David-Vazquez47/Banda-Transportadora/HMI ADAPTER/Marco del HMI.SLDPRT

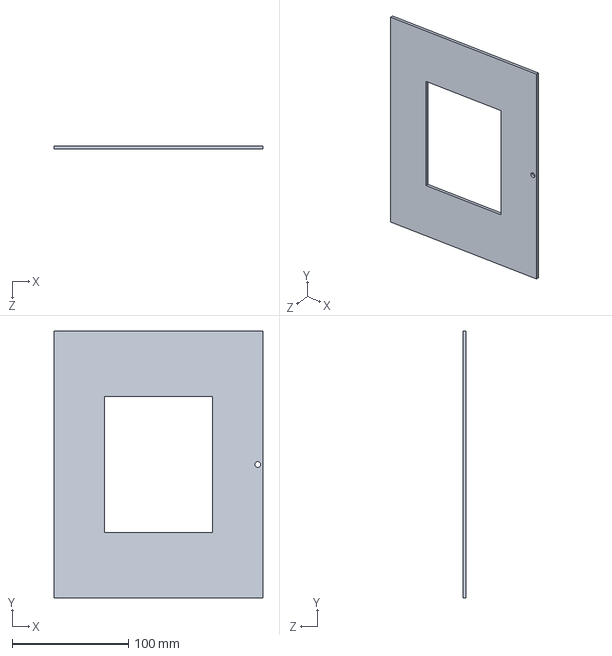
[picture p1: CAD file, 2026-10-13]
HMI ADAPTER/Marco del HMI.SLDPRT
180.0 x 230.0 x 3.00 mm
