David-Vazquez47/Banda-Transportadora/(list of files, cad)

Other CAD files:
HMI ADAPTER/Marco del HMI.DXF
