David-Vazquez47/Banda-Transportadora/HMI ADAPTER/Diseño del Marco.pdf

E E

F F

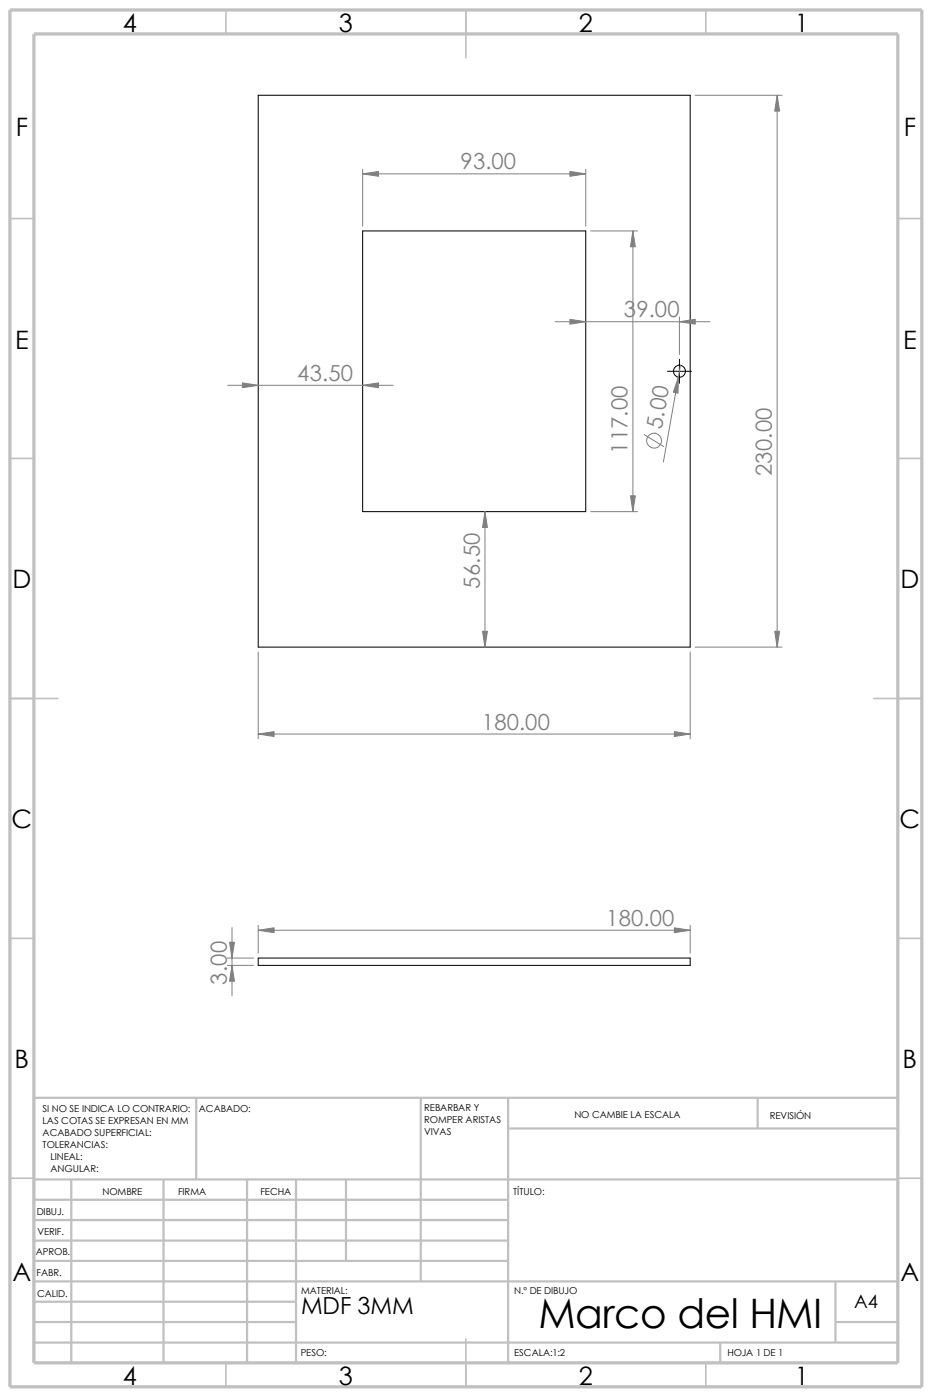
[picture p2: page 1]
REVISIÓN; N.º DE DIBUJO; ESCALA:1:2; HOJA 1 DE 1; PESO:; MDF 3MM; ROMPER ARISTAS; ACABADO:; FABR.; CALID.; VIVAS; REBARBAR Y; MATERIAL:; Marco del HMI ³.00

SI NO SE INDICA LO CONTRARIO:
LAS COTAS SE EXPRESAN EN MM
ACABADO SUPERFICIAL:
TOLERANCIAS:
LINEAL:
ANGULAR:

NO CAMBIE LA ESCALA

NOMBRE | FIRMA | FECHA | TÍTULO:

DIBUJ.
VERIF.
APROB.
