David-Vazquez47/Banda-Transportadora/Planos_Electroneumaticos_Banda_v1.0_20Oct26.pdf

+52 (999) 930 1900

97305

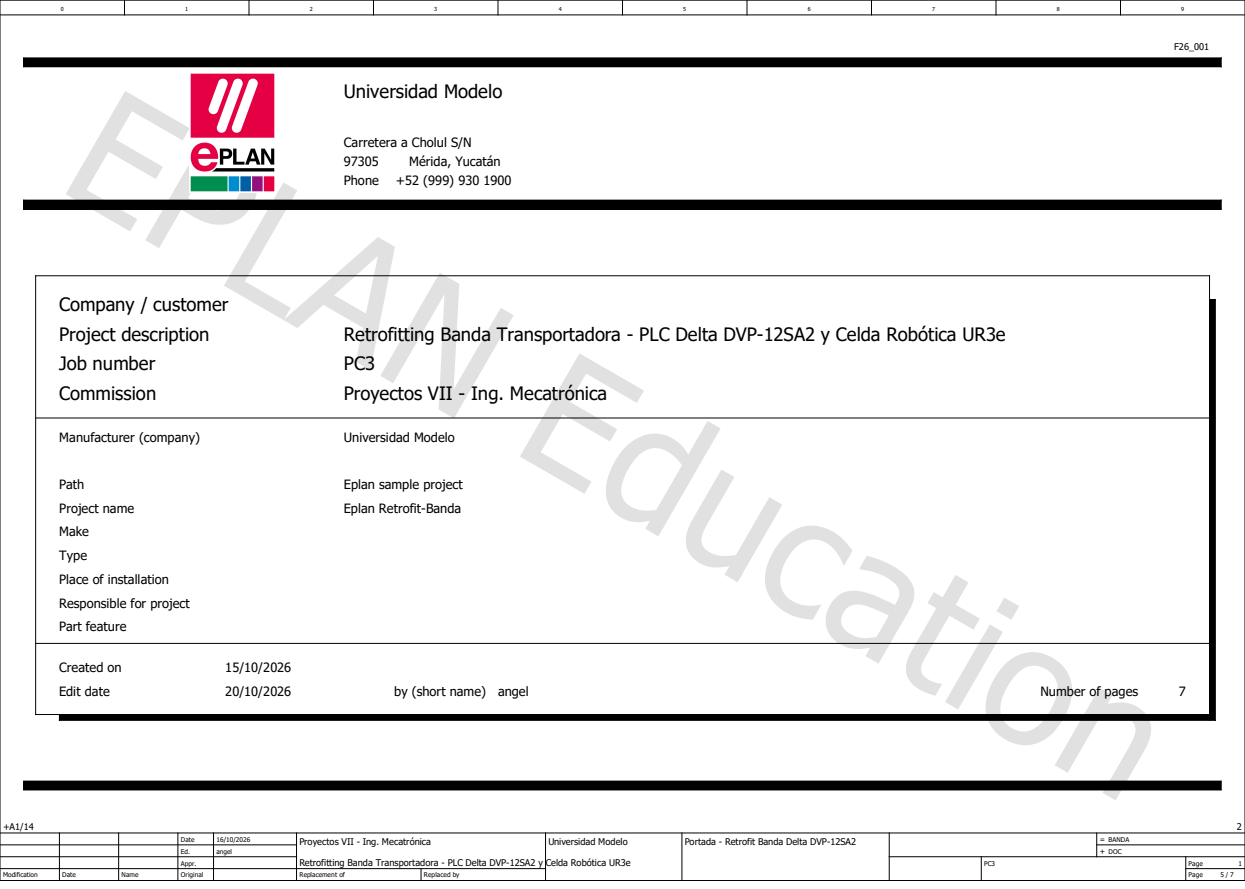
[picture p3: page 1]
Page Page Retrofitting Banda Transportadora - PLC Delta DVP-12SA2 y Celda Robótica UR3e Ed. +A1/14; Original; PC3 Proyectos VII - Ing. Mecatrónica; Date; Replaced by; BANDA DOC; Modification; Appr.; Replacement of; Name; Universidad Modelo; Project description; Retrofitting Banda Transportadora - PLC Delta DVP-12SA2 y Celda Robótica UR3e; Commission; Edit date; Created on; Job number; angel; Carretera a Cholul S/N; Manufacturer (company); Project name; Eplan Retrofit-Banda; Phone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

Proyectos VII - Ing. Mecatrónica

Path
Make
Type
Place of installation
Responsible for project
Part feature

Eplan sample project

by (short name)

Number of pages

Universidad Modelo | Portada - Retrofit Banda Delta DVP-12SA2 | =
16/10/2026 angel | | | 1 +

Page | Page type | Page description | Date | Edited by
=BANDA+A1/10 | Schematic multi-line | Distribución 220VAC / 24VDC y Potencia Motor JSCC | 19/10/2026 | David Vazquez

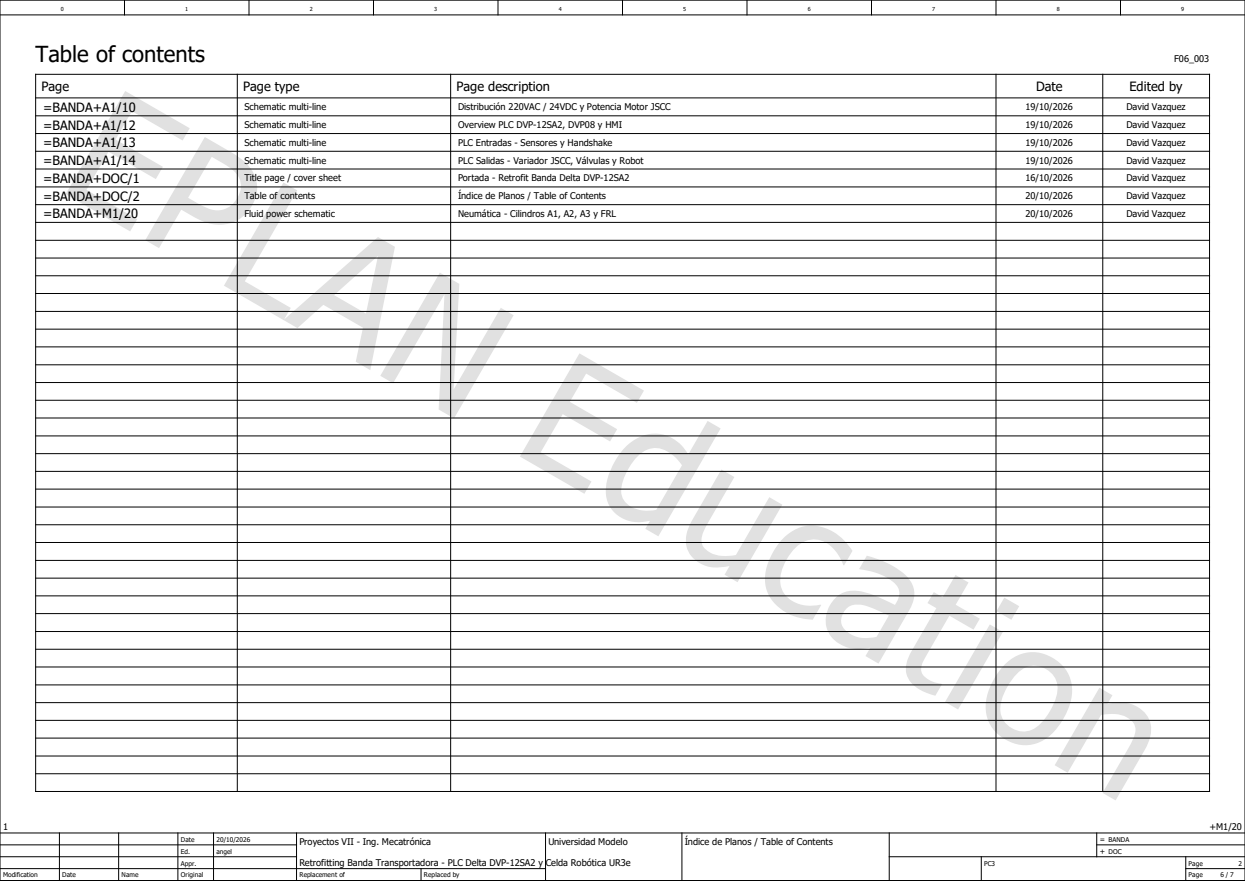
[picture p4: page 2]
Page Page Retrofitting Banda Transportadora - PLC Delta DVP-12SA2 y Celda Robótica UR3e Ed. 1; Original; PC3 Proyectos VII - Ing. Mecatrónica; Date; Replaced by; BANDA DOC; Modification; Appr.; Replacement of; Name

Table of contents

=BANDA+A1/12 | Schematic multi-line | Overview PLC DVP-12SA2, DVP08 y HMI | 19/10/2026 | David Vazquez
=BANDA+A1/13 | Schematic multi-line | PLC Entradas - Sensores y Handshake | 19/10/2026 | David Vazquez
=BANDA+A1/14 | Schematic multi-line | PLC Salidas - Variador JSCC, Válvulas y Robot | 19/10/2026 | David Vazquez
=BANDA+DOC/1 | Title page / cover sheet | | 16/10/2026 Portada - Retrofit Banda Delta DVP-12SA2 | David Vazquez
=BANDA+DOC/2 | Table of contents | | 20/10/2026 Índice de Planos / Table of Contents | David Vazquez
=BANDA+M1/20 | Fluid power schematic | | 20/10/2026 Neumática - Cilindros A1, A2, A3 y FRL | David Vazquez

Universidad Modelo | Índice de Planos / Table of Contents | =
20/10/2026 angel | | | 2 +

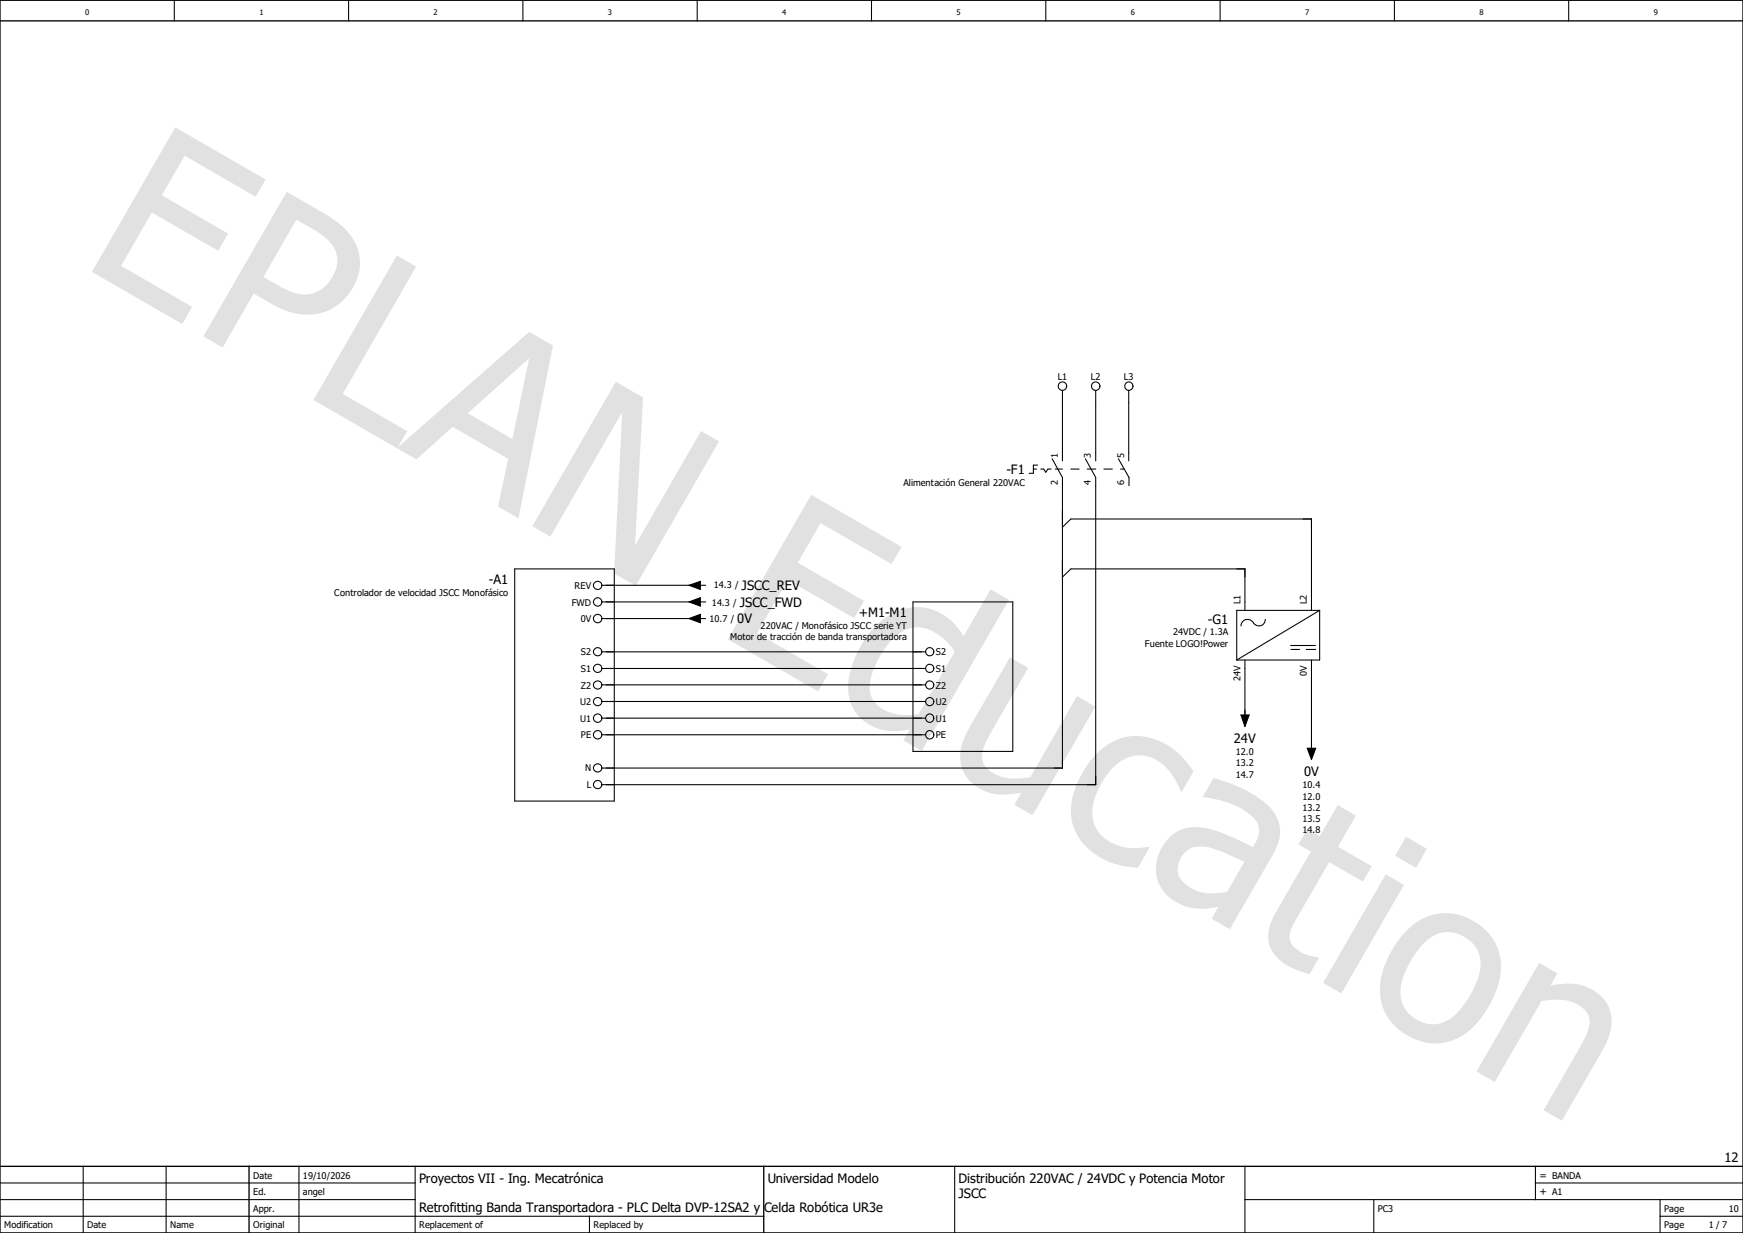
[picture p5: page 3]
Page Page Retrofitting Banda Transportadora - PLC Delta DVP-12SA2 y Celda Robótica UR3e Ed. Original; PC3 Proyectos VII - Ing. Mecatrónica; Date; Replaced by; BANDA; Modification; Appr.; Replacement of; Name; -F1 Alimentación General 220VAC; -A1 Controlador de velocidad JSCC Monofásico; REV; FWD 0V; S2S1Z2U2U1PEN; -G1 24VDC / 1.3A; 220VAC / Monofásico JSCC serie YT Motor de tracción de banda transportadora; 14.3 / JSCC_REV 14.3 / JSCC_FWD

Fuente LOGO!Power +M1-M1

Universidad Modelo | = A1 Distribución 220VAC / 24VDC y Potencia Motor JSCC
19/10/2026 angel | | 10 +

## -PLC1

## -PLC2

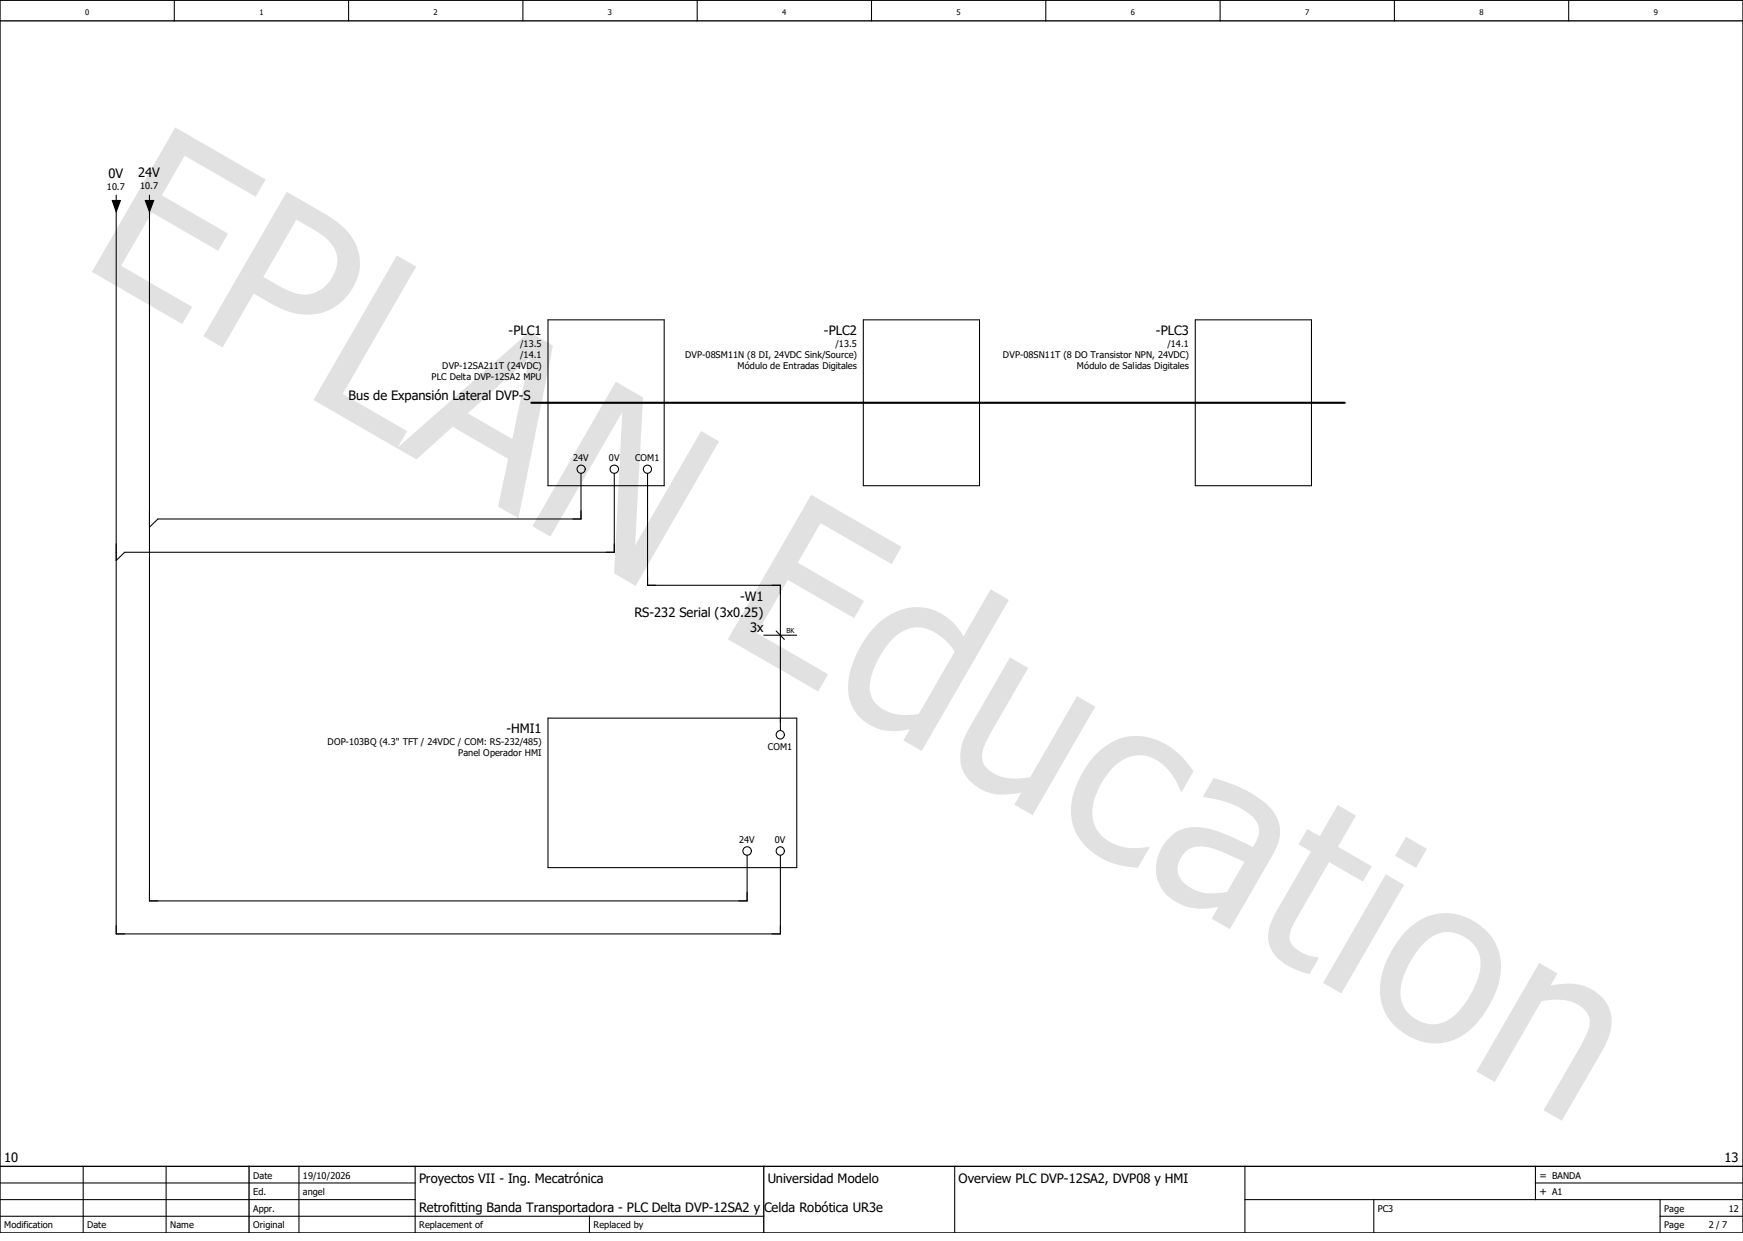
[picture p6: page 4]
Page Page Retrofitting Banda Transportadora - PLC Delta DVP-12SA2 y Celda Robótica UR3e Ed. 10; Original; PC3 Proyectos VII - Ing. Mecatrónica; Date; Replaced by; BANDA; Modification; Appr.; Replacement of; Name; -PLC3; -HMI1 DOP-103BQ (4.3" TFT / 24VDC / COM: RS-232/485) Panel Operador HMI; COM1; 3x RS-232 Serial (3x0.25)

/13.5 DVP-08SM11N (8 DI, 24VDC Sink/Source) Módulo de Entradas Digitales

/14.1 DVP-08SN11T (8 DO Transistor NPN, 24VDC) Módulo de Salidas Digitales

/14.1 DVP-12SA211T (24VDC) PLC Delta DVP-12SA2 MPU

Bus de Expansión Lateral DVP-S

Universidad Modelo | = A1 Overview PLC DVP-12SA2, DVP08 y HMI
19/10/2026 angel | | 12 +

## -PLC1

0V

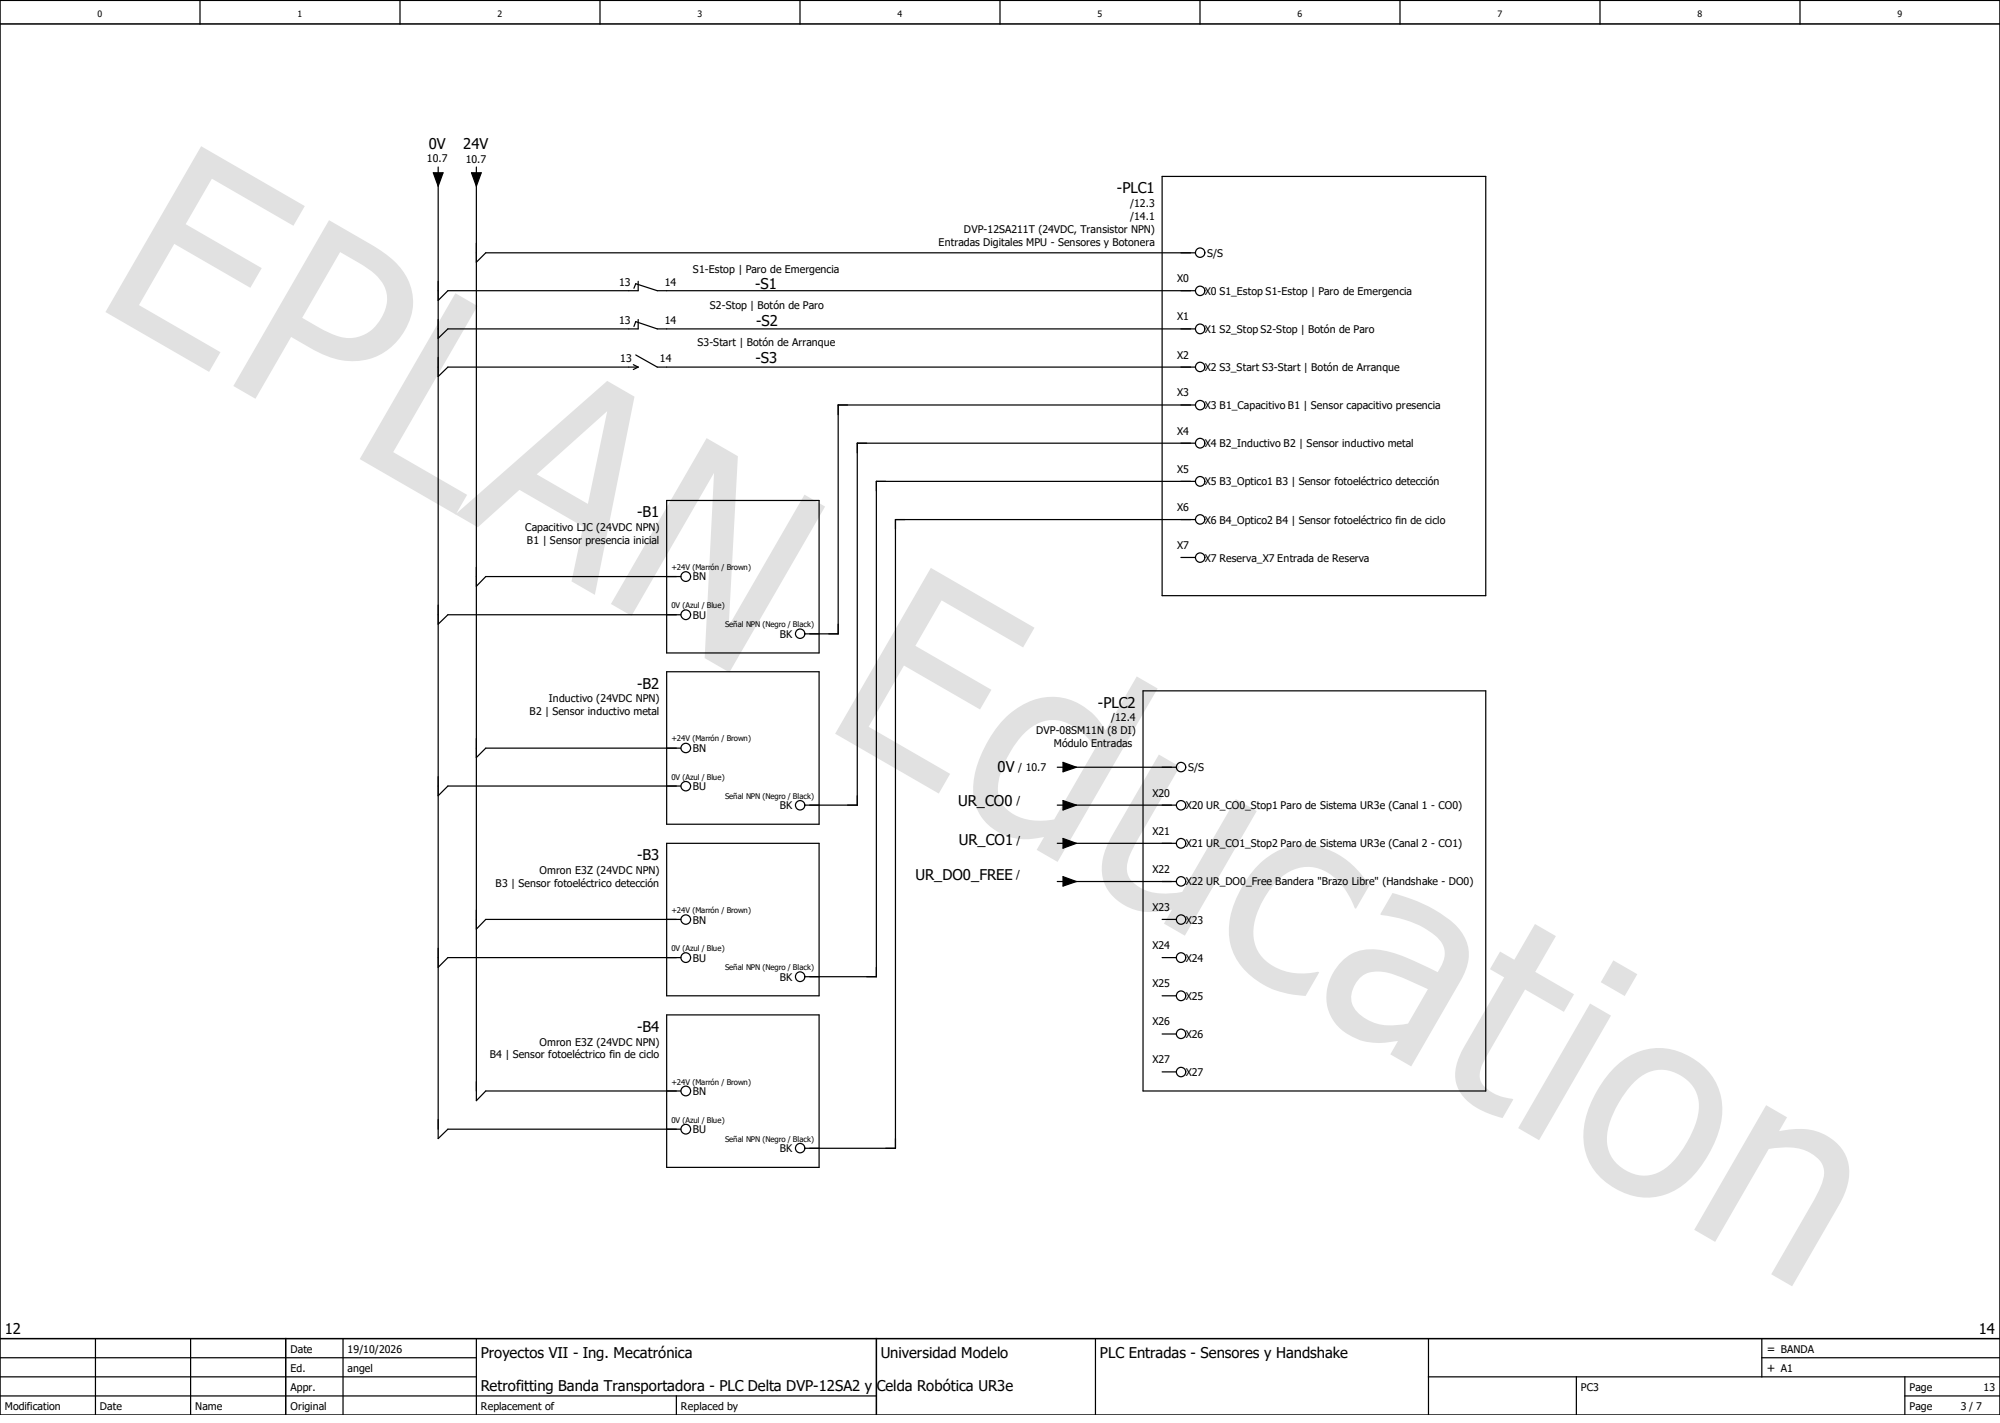
[picture p7: page 5]
Page Page Retrofitting Banda Transportadora - PLC Delta DVP-12SA2 y Celda Robótica UR3e Ed. 12; Original; PC3 Proyectos VII - Ing. Mecatrónica; Date; Replaced by; BANDA; Modification; Appr.; Replacement of; Name; /14.1 DVP-12SA211T (24VDC, Transistor NPN) Entradas Digitales MPU - Sensores y Botonera 13; -S1 S1-Estop | Paro de Emergencia 13; -S2 S2-Stop | Botón de Paro 13; -S3 S3-Start | Botón de Arranque; X0 S1_Estop S1-Estop | Paro de Emergencia X1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

0V (Azul / Blue) BU

Señal NPN (Negro / Black) BK

Universidad Modelo | = A1 PLC Entradas - Sensores y Handshake
19/10/2026 angel | | 13 +

## -PLC1

0V

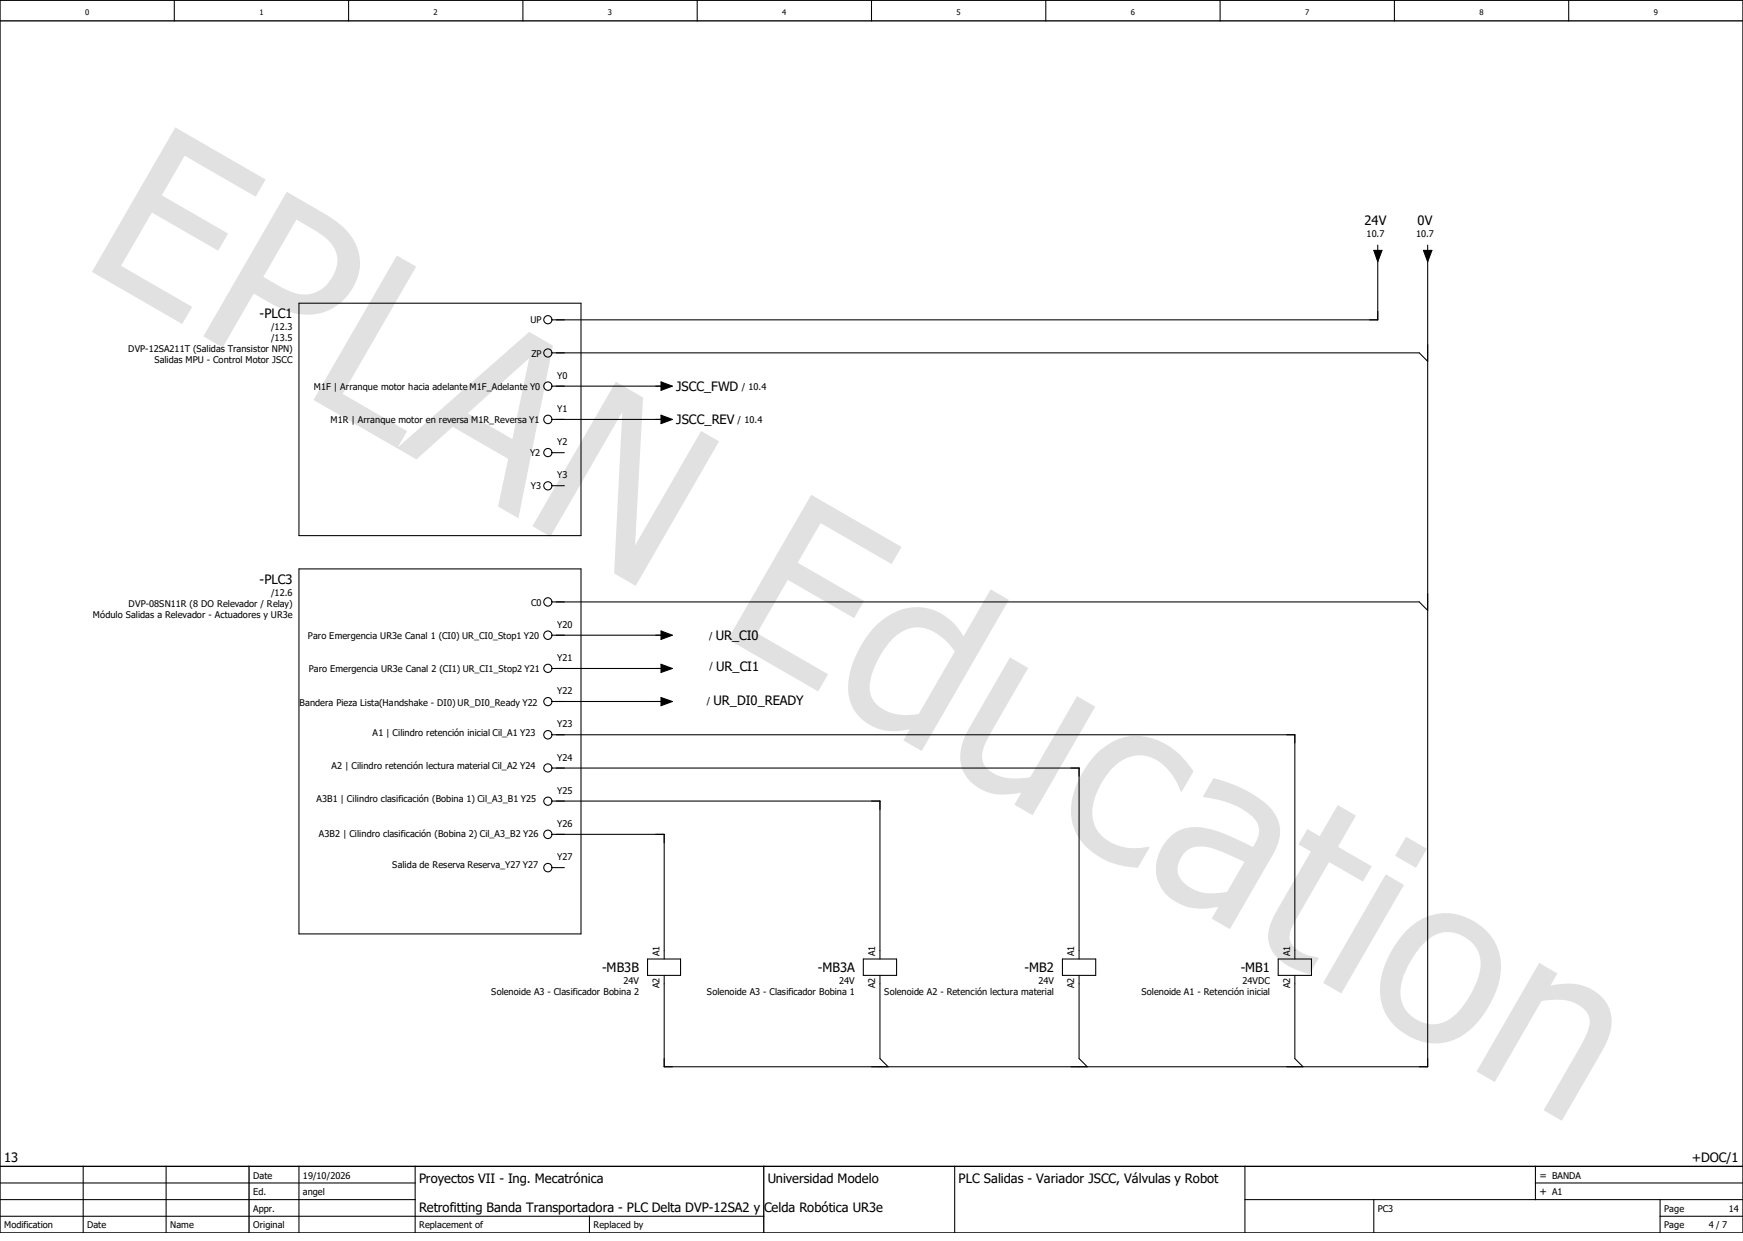
[picture p8: page 6]
Page Page Retrofitting Banda Transportadora - PLC Delta DVP-12SA2 y Celda Robótica UR3e Ed. 13; Original; PC3 Proyectos VII - Ing. Mecatrónica; Date; Replaced by; BANDA; Modification; Appr.; Replacement of; 7 +DOC/1; Name; /13.5 DVP-12SA211T (Salidas Transistor NPN) Salidas MPU - Control Motor JSCC; UPZP; Y0 M1F | Arranque motor hacia adelante M1F_Adelante Y0; Y1 M1R | Arranque motor en reversa M1R_Reversa Y1; -PLC3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

Solenoide A3 - Clasificador Bobina 1 A¹ A²

Solenoide A2 - Retención lectura material A¹ A²

Solenoide A1 - Retención inicial A¹ A²

Solenoide A3 - Clasificador Bobina 2

Universidad Modelo | = A1 PLC Salidas - Variador JSCC, Válvulas y Robot
19/10/2026 angel | | 14 +

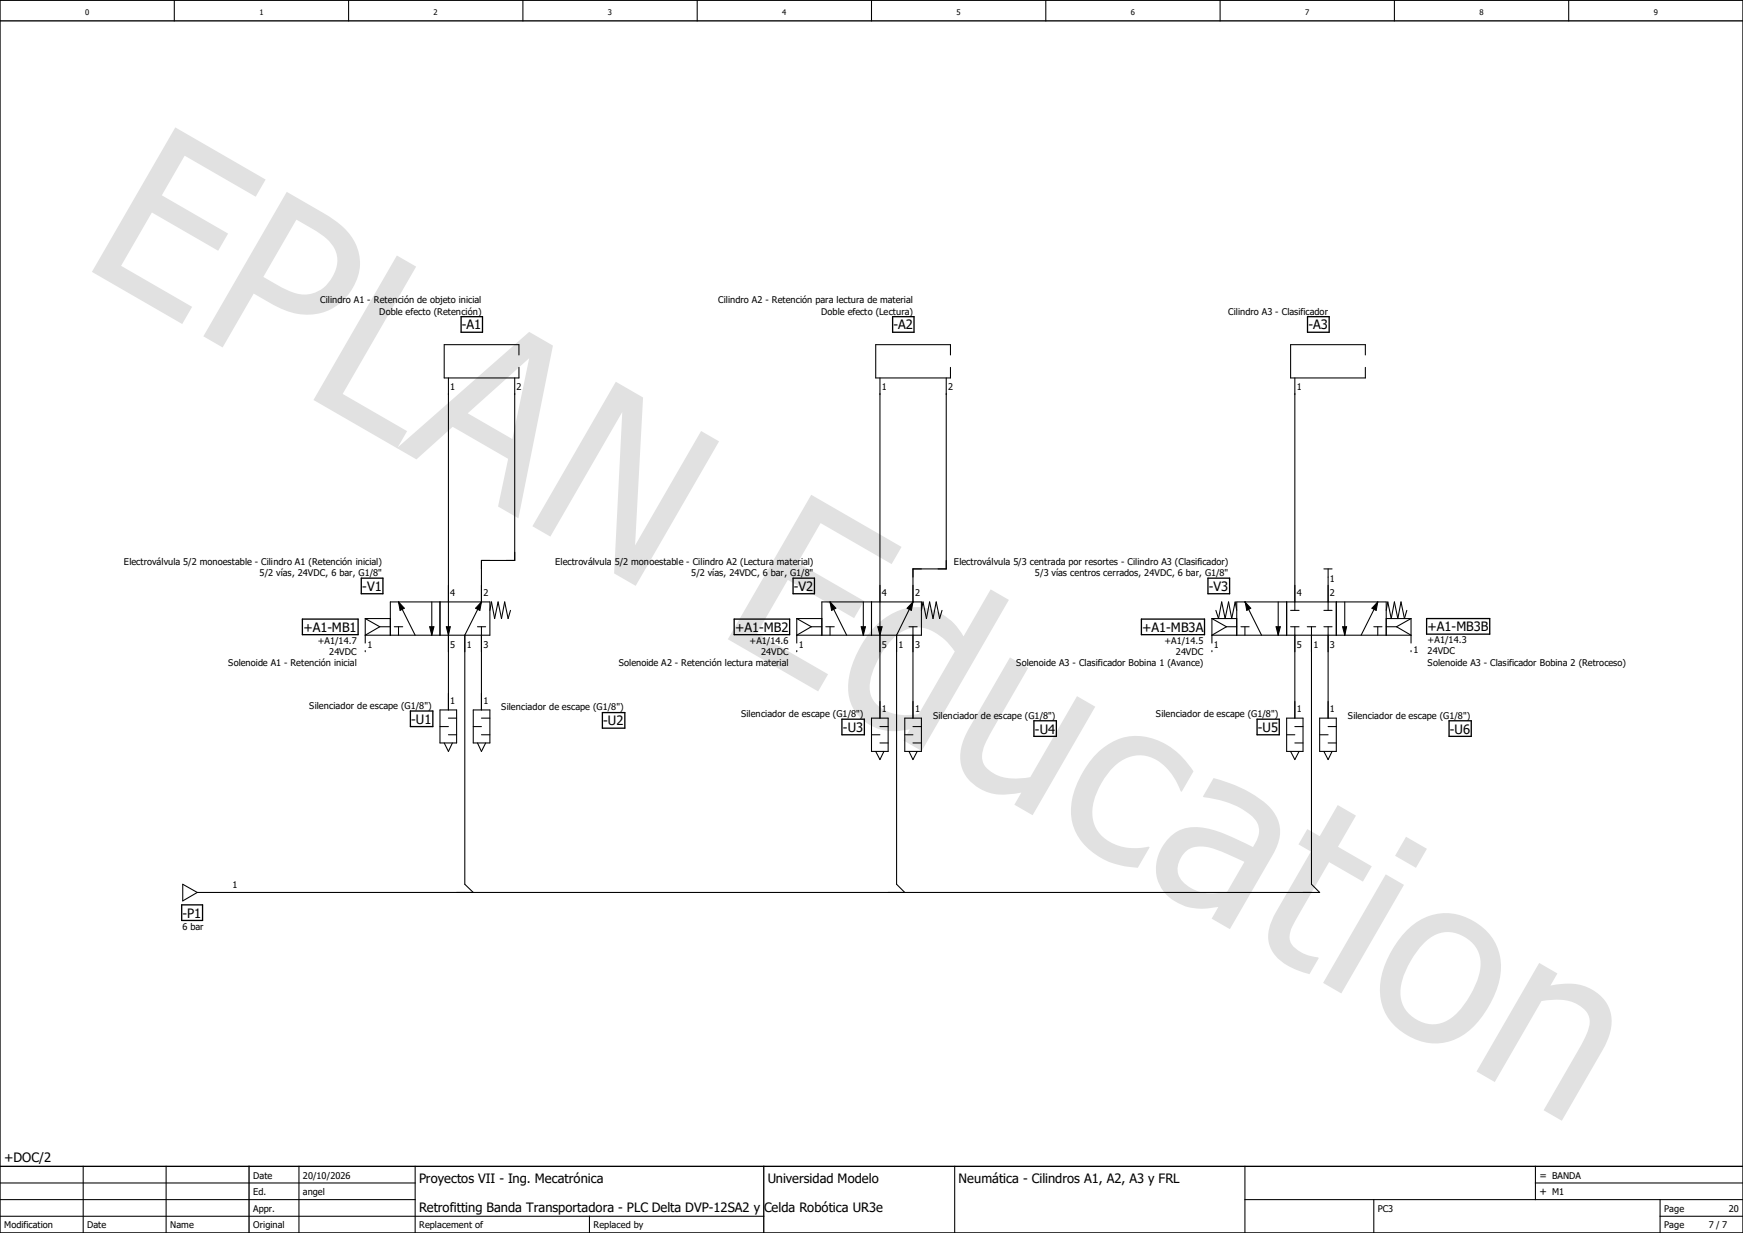
[picture p9: page 7]
Page Page Retrofitting Banda Transportadora - PLC Delta DVP-12SA2 y Celda Robótica UR3e Ed. +DOC/2; Original; PC3 Proyectos VII - Ing. Mecatrónica; Date; Replaced by; BANDA M1 Neumática - Cilindros A1, A2, A3 y FRL; Modification; Appr.; Replacement of; Name; 5/2 vías, 24VDC, 6 bar, G1/8" Electroválvula 5/2 monoestable - Cilindro A1 (Retención inicial); 24VDC; Solenoide A1 - Retención inicial; Solenoide A2 - Retención lectura material; Solenoide A3 - Clasificador Bobina 1 (Avance)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

5/2 vías, 24VDC, 6 bar, G1/8" Electroválvula 5/2 monoestable - Cilindro A2 (Lectura material) 1 +A1-MB1 +A1/14.7

Solenoide A3 - Clasificador Bobina 2 (Retroceso) 4

-U4 Silenciador de escape (G1/8") 1

-U5 Silenciador de escape (G1/8")

-U6 Silenciador de escape (G1/8") 1

Universidad Modelo | =
20/10/2026 angel | | 20 +
