David-Vazquez47/Banda-Transportadora/Banda_UR3e/Banda_UR3e.ini

[PRJ_DATA]
LANG=ENG
CPU=0013
DEVICE_TYPE=1
DEVICE_LABEL=Banda_UR3e
SYNCH_ID=
PRI_PATH=
MONITOR_RADIX=0

[COM_MAN]
DRIVER_ID=15085
DRIVER_NAME=DVP_Driver
LOCAL_IP=
TARGET_IP=0.0.0.0
TARGET_PORT=0
TARGET_STATION=0
IS_NNU=0
COM_NUM=3
CON_INTERFACE=1
FIRST_STATION=
ETH_CARD_NAME=
ETH_CARD_MAC_ADDR=

[HW_CFG]

[NW_CFG]

[CONNECT_TO]
AH_MC_CONNECT_TYPE=TO AH MC MODULE
AH_CONNECT_RACK=1
AH_CONNECT_SLOT=0
MC_CONNECT_RACK=1
MC_CONNECT_SLOT=0

[MDI_NAME_GROUP]
MDICOUNT=6
MDINAME_0=Alarms_PouType
MDINAME_1=Main_PouType
MDINAME_2=GlobalVar
MDINAME_3=DevCom
MDINAME_4=HMI_PouType
MDINAME_5=Power_PouType

[Alarms_PouType]
WindowState=2
Top=-31
Left=-8
Height=950
Width=1600

[Main_PouType]
WindowState=0
Top=52
Left=52
Height=483
Width=988

[GlobalVar]
WindowState=0
Top=78
Left=78
Height=483
Width=988

[DevCom]
WindowState=0
Top=52
Left=52
Height=487
Width=963

[HMI_PouType]
WindowState=0
Top=78
Left=78
Height=487
Width=992

[Power_PouType]
WindowState=0
Top=104
Left=104
Height=487
Width=992
