David-Vazquez47/Banda-Transportadora/(commit log)

2026-10-13 Prueba de entradas y Salidas
2026-10-13 Diseño V0 del marco del HMI
    Se diseño un marco para meter el HMI Delta en el agujero que dejo el anterior HMI
2026-10-13 Diseño del Marco
    Se creo el documento donde se establece el diseño y medidas del adaptador HMI
2026-10-14 Configure DVP driver and monitor views
    Update the project connection settings to use the DVP driver on COM3 and save the GlobalVar and Monitor Table views alongside the main program window.
2026-10-17 Add EPLAN conveyor retrofit project
    Se añade el proyecto EPLAN para los dibujos eléctricos y neumáticos, que incluye un PLC Delta DVP-12SA2 y una celda robótica UR3e.
2026-10-18 Update EPLAN conveyor retrofit project
    Actualiza la base de datos del proyecto para la estructura de las hojas y se realizo la parte de conexiones 220V
2026-10-19 Expand EPLAN project with seven pages
    Entradas Digitales MPU - Sensores y Botonera
    Cableado de botonera (-S1, -S2, -S3), sensores NPN (-B1 a -B4) en modo SINK y módulo DVP-08SM para señales de Handshake con robot UR3e en modo SOURCE.
2026-10-19 Diseño de salidas del PLC
    Se completó el diseño de las salidas del sistema de automatización. En la CPU principal (-PLC1 Delta DVP-12SA211T), se cablearon las salidas a transistor Y0 (JSCC_FWD) e Y1 (JSCC_REV) con común ZP a $0V para gobernar el sentido de giro del variador monofásico JSCC sin relevadores mecánicos intermedios. Se implementó el módulo de expansión a relevador (-PLC3 Delta DVP-08SN11R) con su común C0 conectado a 24V. A través de contactos secos, se cablearon las señales activas de seguridad redundante (Y20, UR_CI0, Y21, UR_CI1) y la bandera de Handshake Y22 (UR_DI0_READY) hacia el robot Universal Robots UR3e. Se conectaron las salidas Y23 a Y26 hacia los ter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
2026-10-20 Sección Electroneumática
    Se concluyó el diseño del circuito electroneumático bajo norma ISO 1219 utilizando la biblioteca PNE1ESS. Se definió la toma principal de aire comprimido a 6 bar (-P1) mediante un colector común que alimenta la vía 1 de las electroválvulas. Se integraron los cilindros de doble efecto de retención inicial (-A1) y lectura de material (-A2) controlados por válvulas 5/2 monoestables (-V1 y -V2) con retorno por muelle. Para el clasificador se implementó un cilindro de doble efecto (-A3) accionado por una válvula 5/3 de centros cerrados (-V3) con doble solenoide y centrado por resortes. Los escapes de aire 3 y 5 se equiparon con silenciadores de desfogue (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
2026-10-20 Actualización de propiedades
    docs(eplan): actualizar metadatos institucionales del proyecto y exportar planos a PDF
    - Actualización de propiedades del proyecto (Creator / Company) con datos oficiales:
    * Autor: Angel David Vázquez Mayo
    * Institución: Universidad Modelo (Mérida, Yucatán)
    * Asignatura: Proyectos VII - Ing. Mecatrónica
    * Eliminación de datos predeterminados de plantilla de muestra en carátula
    - Regeneración de tabla de contenido automática (Página 2)
    - Compilación y exportación del juego completo de planos electroneumáticos a formato PDF vectorial
2026-10-20 Mejorar el archivo README con detalles del proyecto y el mapeo de E/S
    Documentación del proyecto actualizada, con descripciones detalladas de la estructura del proyecto, el mapeo de entradas/salidas y las especificaciones técnicas.
2026-10-20 Programación Lógica en ISPSoft
    feat(plc): implementar lógica Ladder de secuencia GRAFCET Nivel 2 en ISPSoft
    - Declaración y documentación de tabla de variables en Device Comment:
    * Entradas digitales locales (X0 a X6) y de módulo DVP-08SM para robot UR3e (X20 a X22)
    * Salidas digitales locales (Y0, Y1) y módulo DVP-08SN para electroválvulas y Handshake (Y20 a Y26)
    * Memorias internas de etapa (M0 a M9) y marca especial de arranque (M1002)
    * Temporizadores de maniobra neumática (T0, T1, T2)
    - Implementación de arquitectura de control secuencial sin instrucciones SET/RST:
    * Lógica de interbloqueo y autoenclavamiento por memorias de estado (M0 a M9)
    * Transición de arra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
2026-10-26 HMI Main
    Diseño del HMI pantalla Main, con contador de cajas y secuencia de actuadores
2026-10-27 Diseño del HMI Menu - Automatico - Manual
    Se creo y el diseño del HMI de los diferentes pantallas
    Principal, Automatico, Manual, seguido de la logica del cambio de secuencias
2026-10-27 Actualizacion del codigo para la secuancia HMI
    Rediseño del ladder para implementar el HMI, ademas de la secuencia de comunicacion con UR- PLC - HMI
2026-11-09 Añadido de HMI Alarmas
    Se añadió la respectiva pantalla de alarmas con sus respectivas descripciones
2026-11-09 Se añadió la sección de alarmas
    Se modifico el Ladder para añadir las alarmas en memoria con su propio reset, ademas de que se modifico la seguridad del las salidas
2026-11-11 actualizar enlace permanente del video demostrativo de auditoría PC4
    - Sustitución del enlace temporal por hipervínculo institucional en SharePoint/OneDrive:
    * URL: unimodelo-my.sharepoint.com/...
    * Acceso directo para auditoría docente (Dr. Rodrigo Solís Ortega)
    * Registro audiovisual de la primera prueba funcional As-Built (duración reglamentaria)
    - Actualización de secciones de acceso rápido y metadatos de trazabilidad en README.md
2026-11-13 Actualización de Componentes de la Banda
    Se realizo el cambio de los diagramas para cuadrar con la nueva distribución de la banda transportadora, quitando una válvula 5/3 y el actuador de retención
2026-11-13 Se realizo la actualizacion de alarmas para poder activar y dejar la bandera de la falla
    Se añadió la sección de alarmas para, el paro de emergencia, el tiempo del UR3e se paso de limite, o se desconecto el UR3e
2026-11-13 Se añadió la pantalla de las alarmas
    Se añadió la sección de alarmas en conjunto a la configuración de las alarmas para poder ver el historial del HMI
